JM-DTCKT/EventTransformer/rtl/softmax/Softmax_Top.v

// -----------------------------------------------------------------------------
// Softmax_Top : attention softmax — `Softmax_Unit` 래퍼
//
// 코어는 열(32행)을 매 사이클 받아 max 를 수신 중에 확정하고, RECV/EXP/MUL 세
// 단계를 **서로 다른 Tile 로 겹칩니다** — Tile 하나가 `T + ~40` 사이클입니다.
// 이 래퍼는 엔진 인터페이스에 맞춰 두 가지를 붙입니다.
//
// ## 1. 끝 표시 — 타일 `n_tile` 개를 **연달아** 처리합니다
//
// 엔진은 열 수 `n_col`(= Lk) 과 타일 수 `n_tile`(= ⌈M/32⌉) 을 줍니다. 여기서
// 세어 `n_col-1` 번째 열마다 `in_last` 를 실어 주고, 카운터를 되감아 다음 타일을
// 이어서 받습니다. **이 되감기가 없으면 두 번째 타일의 `in_last` 가 영영 안 뜹니다.**
//
// 코어(`Softmax_Unit`)는 원래부터 서로 다른 타일로 RECV/EXP/MUL 세 단계를 겹치도록
// 설계돼 있습니다 — 타일을 하나만 주면 그 파이프라인이 통째로 놉니다.
//
// ## 2. 출력 포맷 Q1.14 → uint8
//
// 코어는 signed Q1.14 를 내는데 `attn·V` 의 A 피연산자는 **uint8 코드**입니다
// (골든의 `attn_int = round(attn / softmax_scale)`, softmax_scale = 16513·2^-21):
//
//     code = round( y_q14 · 2^-14 / softmax_scale )
//          = (y_q14 · SM_MULT + 2^(SM_SH-1)) >> SM_SH
//
// 기본값 SM_MULT=16253, SM_SH=21 이 그 비율입니다 (상대오차 3e-6). y 는 [0,1]
// 이라 부호가 안 서고, y=1 이어도 code=127 이라 포화도 없습니다.
// -----------------------------------------------------------------------------
`timescale 1ns/1ps

module Softmax_Top #(
    parameter N        = 32,        // 레인 = 쿼리
    parameter CMAX     = 128,       // 최대 클래스 수 = Lk 상한
    parameter SM_MULT  = 16253,     // Q1.14 → uint8 (softmax_scale 의 역수)
    parameter SM_SH    = 21
)(
    input  wire              clk,
    input  wire              rst,

    input  wire              start,      // n_col / n_tile 을 잡고 입력 수집 시작
    input  wire [7:0]        n_col,          // 클래스 수 = Lk (타일 하나의 열 수)
    input  wire [5:0]        n_tile,         // 연달아 처리할 32행 타일 수 (= ⌈M/32⌉)
    output reg               done,

    // ---- 입력: 클래스 하나 = 32레인 Q6.9 ----
    input  wire              in_valid,
    input  wire [N*16-1:0]   in_data,

    // ---- 출력: 클래스 하나 = 32레인 uint8 ----
    output reg               out_valid,
    output reg  [7:0]        out_n,
    output reg               out_last,       // 이 타일의 마지막 열 (소비자가 mt 를 셈)
    output reg  [N*8-1:0]    out_data
);
    // =========================================================================
    // 입력 : n_col 를 세어 마지막 열에 in_last
    //
    // `n_col` 을 레지스터로 옮겨 담지 않습니다. 엔진이 명령어 내내 `op_nout` 을 잡고
    // 있으므로 그대로 쓰면 됩니다. 옮겨 담으려다 **첫 열을 흘리는** 실수를
    // 했었는데, 그러면 그 타일이 영영 안 끝나고 출력이 **한 타일씩 밀립니다**
    // (다음 타일의 첫 열이 들어와야 앞 타일이 완성됩니다).
    // =========================================================================
    wire       core_iready;
    wire [7:0] n_col_eff  = (n_col  == 8'd0) ? 8'd1 : n_col;
    wire [5:0] n_tile_eff = (n_tile == 6'd0) ? 6'd1 : n_tile;
    reg  [7:0] in_cnt;
    reg  [5:0] in_tile;                                      // 다 받은 타일 수
    wire       take    = start && (in_tile < n_tile_eff);    // 아직 받을 타일이 남았나
    wire       in_last = (in_cnt == n_col_eff - 8'd1);       // 이 타일의 마지막 열

    // [자원] 8비트 비교기는 그대로 두고 6비트 카운터 하나만 얹습니다. 되감기는
    // 기존 `in_last` 비교기를 재사용하므로 추가 비교기가 없습니다.
    always @(posedge clk) begin
        if (rst || !start) begin
            in_cnt <= 8'd0;  in_tile <= 6'd0;
        end else if (in_valid && core_iready && take) begin
            in_cnt  <= in_last ? 8'd0 : in_cnt + 8'd1;
            in_tile <= in_tile + {5'd0, in_last};
        end
    end

    // =========================================================================
    // 코어
    // =========================================================================
    wire              core_ovalid, core_olast;
    wire [N*16-1:0]   core_ocol;

    Softmax_Unit #(.LANE(N), .TMAX(CMAX), .DW(16), .IF(9),
                  .OW(16), .OF(14), .EW(17), .EF(16), .RW(18), .RF(17),
                  .BRAM_LAT(1)) u_core (
        .clk(clk), .rst_n(~rst),
        .in_valid(in_valid && take), .in_ready(core_iready),
        .in_col(in_data), .in_last(in_last),
        .out_valid(core_ovalid), .out_col(core_ocol), .out_last(core_olast));

    // =========================================================================
    // 출력 : Q1.14 → uint8, 열 번호를 세어 붙임
    // =========================================================================
    // 변환은 **조합**으로 하고 레지스터에는 비블로킹으로만 담습니다.
    // (클럭 블록 안에서 출력 레지스터에 블로킹 대입을 하면 같은 엣지에 읽는
    //  쪽과 경쟁해 값이 갈립니다 — attention 결과가 통째로 깨졌습니다.)
    wire [N*8-1:0] u8_bus;
    genvar q;
    generate
        for (q = 0; q < N; q = q + 1) begin : Q2U8
            wire signed [15:0] yq = core_ocol[q*16 +: 16];
            wire signed [47:0] pr = ($signed({{32{yq[15]}}, yq}) * SM_MULT
                                     + (48'sd1 <<< (SM_SH - 1))) >>> SM_SH;
            assign u8_bus[q*8 +: 8] = (pr < 0)   ? 8'd0
                                    : (pr > 255) ? 8'd255 : pr[7:0];
        end
    endgenerate

    // `out_n` 는 **지금 나가는** 열 번호여야 합니다. 데이터와 같은 엣지에
    // 증가시키면 첫 열이 1번 자리에 써져 전체가 한 칸씩 밀립니다.
    reg [7:0] out_cnt;
    reg [5:0] out_tile;
    always @(posedge clk) begin
        if (rst) begin
            out_valid <= 1'b0; out_n <= 8'd0; out_data <= {(N*8){1'b0}};
            out_last <= 1'b0; done <= 1'b0; out_cnt <= 8'd0; out_tile <= 6'd0;
        end else begin
            out_valid <= core_ovalid;
            out_last  <= core_ovalid && core_olast;   // 소비자가 행타일 베이스를 올림
            if (core_ovalid) begin
                out_data <= u8_bus;
                out_n    <= out_cnt;
                out_cnt  <= core_olast ? 8'd0 : (out_cnt + 8'd1);
                if (core_olast) out_tile <= out_tile + 6'd1;
            end
            // **마지막 타일**의 마지막 열을 내보낸 뒤 완료. start 가 내려가면 해제.
            if (core_ovalid && core_olast && (out_tile == n_tile_eff - 6'd1)) done <= 1'b1;
            else if (!start) begin done <= 1'b0; out_tile <= 6'd0; end
        end
    end
endmodule
