JM-DTCKT/EventTransformer/rtl/Axis_Loader_Nl.v

// -----------------------------------------------------------------------------
// Axis_Loader_Nl : AXI-Stream(128b) → 온칩 메모리 순차 적재 (목적지마다 폭이 다름)
//
// `fpga/Axis_Loader` 는 메모리 폭이 하나(256b)라 워드당 비트 수가 파라미터로
// 고정이었습니다. 여기는 **A_Mem 만 512b** 이고 나머지는 256b 입니다:
//
//   sel 0 W_Mem   256b → 2 beat/word
//   sel 1 A_Mem   512b → 4 beat/word      ← 32레인 x 16b (int8/bf16 공용)
//   sel 2 PB_Mem  256b → 2 beat/word
//   sel 3 PG_Mem  256b → 2 beat/word
//
// 그래서 워드당 비트 수를 **arm 시점의 sel 로 결정**합니다. 그 외에는 원본과
// 같습니다 — 스트림 바이트 순서가 곧 메모리 이미지이고, 재배치는 전부
// `sw/pack_nl.py` 가 미리 해 둡니다.
//
// 256b 목적지일 때 상위 256b 는 그대로 흘려보냅니다 (FFN_Engine 이 하위만 씀).
// tready 는 항상 1 — 목적지가 BRAM 이고 2~4비트당 1워드라 백프레셔가 없습니다.
// -----------------------------------------------------------------------------
module Axis_Loader_Nl #(
    parameter SW = 128,          // 스트림 폭
    parameter DW = 512,          // 가장 넓은 메모리 (A_Mem)
    parameter AW = 13            // 가장 큰 메모리의 워드 주소폭 (W_Mem)
)(
    input  wire            clk,
    input  wire            rst,

    input  wire            arm,           // 1클럭 펄스: sel/base 를 잡고 카운터 리셋
    input  wire [1:0]      arm_sel,
    input  wire [AW-1:0]   arm_base,

    input  wire            s_tvalid,
    output wire            s_tready,
    input  wire [SW-1:0]   s_tdata,
    input  wire            s_tlast,

    output reg             ld_we,
    output reg  [1:0]      ld_sel,
    output reg  [AW-1:0]   ld_addr,
    output reg  [DW-1:0]   ld_data,

    output reg  [AW-1:0]   words_written
);
    assign s_tready = 1'b1;

    reg [1:0]    last_beat;      // 워드의 마지막 비트 번호 (2beat→1, 4beat→3)
    reg [1:0]    phase;
    reg [AW-1:0] wptr;
    reg [DW-1:0] sh;

    always @(posedge clk) begin
        if (rst) begin
            ld_we <= 1'b0; ld_sel <= 2'd0; ld_addr <= {AW{1'b0}};
            ld_data <= {DW{1'b0}}; phase <= 2'd0; wptr <= {AW{1'b0}};
            last_beat <= 2'd1; words_written <= {AW{1'b0}};
        end else begin
            ld_we <= 1'b0;

            if (arm) begin
                ld_sel        <= arm_sel;
                wptr          <= arm_base;
                phase         <= 2'd0;
                last_beat     <= (arm_sel == 2'd1) ? 2'd3 : 2'd1;
                words_written <= {AW{1'b0}};
            end else if (s_tvalid) begin
                // 하위 비트가 먼저 옵니다 — 오른쪽으로 밀어 넣습니다.
                sh <= {s_tdata, sh[DW-1:SW]};
                if (phase == last_beat) begin
                    // 2비트 모드면 방금 것이 상위 절반이라 위쪽 256b 에 있습니다.
                    ld_data <= (last_beat == 2'd1)
                             ? {{(DW/2){1'b0}}, s_tdata, sh[DW-1:DW-SW]}
                             : {s_tdata, sh[DW-1:SW]};
                    ld_addr <= wptr;
                    ld_we   <= 1'b1;
                    wptr    <= wptr + 1'b1;
                    phase   <= 2'd0;
                    words_written <= words_written + 1'b1;
                end else begin
                    phase <= phase + 1'b1;
                end
            end

            if (s_tvalid && s_tlast) phase <= 2'd0;   // 워드 경계가 안 맞으면 버림
        end
    end
endmodule
