JM-DTCKT/EventTransformer/(commit log)

2026-09-01 Fix: Edit Residual Path
    [EvT_Engine.v]
2026-09-01 Fix: Finish Residual Path
    [EvT_Engine.v, Format_Cast_Act.v]
2026-09-02 softmax-GEMM Tile Pipelining
    QK 를 행타일마다 쪼개던 것을 `M=32 -> 96` 한 명령어로 합쳐, softmax 가 도는
    동안 배열이 다음 행타일을 계속 돌게 했습니다. 명령어 123 -> 99, QK 36 -> 12.
    ## 왜
    QK 명령어 292 사이클 중 147(50 %)이 softmax 대기였습니다. `Softmax_Unit` 은
    RECV/EXP/MUL 3단을 **서로 다른 타일로** 겹치도록 설계돼 있는데, 명령어당 타일이
    하나뿐이라 그 파이프라인이 통째로 놀았습니다.
    ## 무엇
    - sw/schedule_evt.py : QK 를 head 당 1개(M=LAT)로. SM 영역 129 -> 387 워드
    (행타일 QT 벌, 스트라이드는 최악치 고정). AV 는 AIN 에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
2026-09-02 docs: README 를 softmax-GEMM 타일 파이프라이닝 결과로 갱신
    - §요약/§1 : 보드 실측 264 샘플 갱신 (6.820 ms · 146.6 샘플/s · 258/264).
    지연 분해(PL 6.792 / E2E 6.820 / PS 0.4 %)와 샘플별 편차 추가.
    - §2 : build_qk3 리소스 · 전력 내역 · 에너지 효율(68.6 mJ, −23 %).
    - §4 : body 118 -> 94. PS 오버헤드 0.9 % -> 0.4 %.
    AV 가 OSTR 을 bias_v 로 쓰고 있어 병합하지 않은 이유 명시.
    - §6 : Softmax_Top 의 n_tile/out_last, xbuf 4 뱅크(백프레셔 경로 부재),
    Fp32_Add 트리 LZC.
    - §8 : "사이클을 줄인 두 가지" 절 신설 — RES 파이프라인화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
2026-09-02 feat: A8W4 양자화 (활성 int8 / 가중치 int4) 적용
    가중치를 int4 니블 팩으로 바꾸고 보드까지 검증했습니다. 정확도 257/264
    (97.35 %), 시간은 A8W8 과 동일하며 BRAM 이 443 -> 379 (-64, -14.4 %)
    줄었습니다. DSP 패킹은 적용하지 않았습니다.
    RTL
    - EvT_Engine : parameter W_W 신설. W_Mem 을 N*W_W 폭으로 낮추고, 읽은
    니블을 레인마다 int8 로 부호확장해 배열 B 포트에 넣습니다. QK/AV 의 B 는
    A_Mem 의 int8 이므로 배열 쪽 경로는 하나로 유지합니다.
    - Top : parameter W_W = 4 를 엔진에 전달.
    SW
    - pack_evt.py : --w_pack_bits 4 로 니블 팩 (짝수 레인 = 하위 니블).
    - schedule_evt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
2026-09-03 feat: A8W4 + DSP Packing — DSP 를 안 늘리고 처리량 2배
    DSP48E2 의 27x18 곱셈기에 int4 가중치 두 개를 내장 pre-adder 로 실어, 배열이
    타일당 32x64 를 냅니다. DSP 는 1,974 개 그대로이고 보드 지연이 6.792 -> 5.227 ms
    (-23.0 %), 처리율 146.6 -> 190.3 샘플/s (+29.8 %) 입니다. 정확도는 257/264
    (97.35 %) 로 패킹 전과 **오분류 샘플 목록까지 동일**합니다.
    패킹
    - PE_OS : A = w1<<21, D = w0, AD = D+A (INMODE=5'b00100), B = 활성값.
    두 곱이 P 안에서 자리로 분리됩니다 (하위 [20:0], 상위 [40:21]).
    ADREG/BREG 로 DSP 지연이 2 -> 3, shadow 32 -> 41비트.
    attention 은 int8 을 두 니블로 쪼갠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
